rimio/cat-a-hack/README.md

# cat-a-hack

Prototyping board for PC/μC to ham radio transceiver isolation.

 This work is licensed under a [Creative Commons Attribution-ShareAlike 4.0 International License](http://creativecommons.org/licenses/by-sa/4.0/).
