rimio/cat-a-hack/revisions/0/schematic.pdf

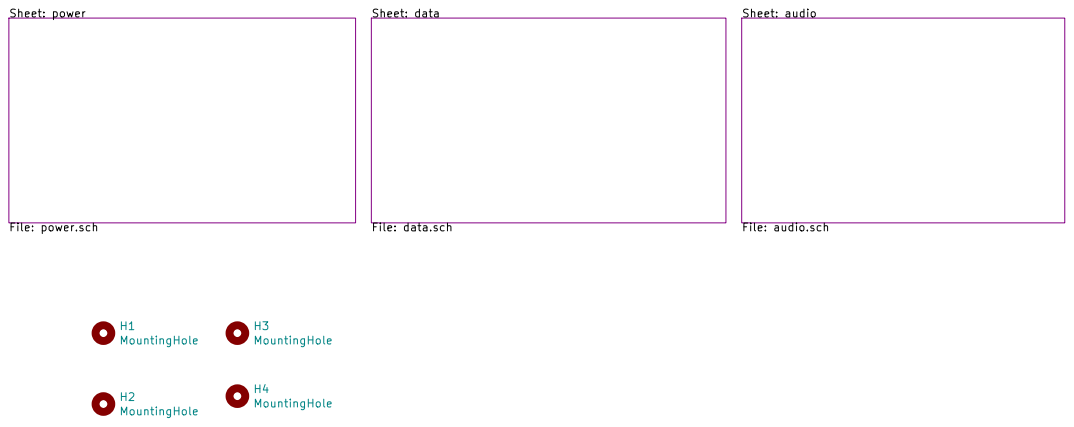
[picture p1: page 1]

File: catahack.sch Sheet: / Vasile Vilvoiu (YO7JBP) CAT and audio hackable isolation board

Id: 1/5 Title: cat-a-hack

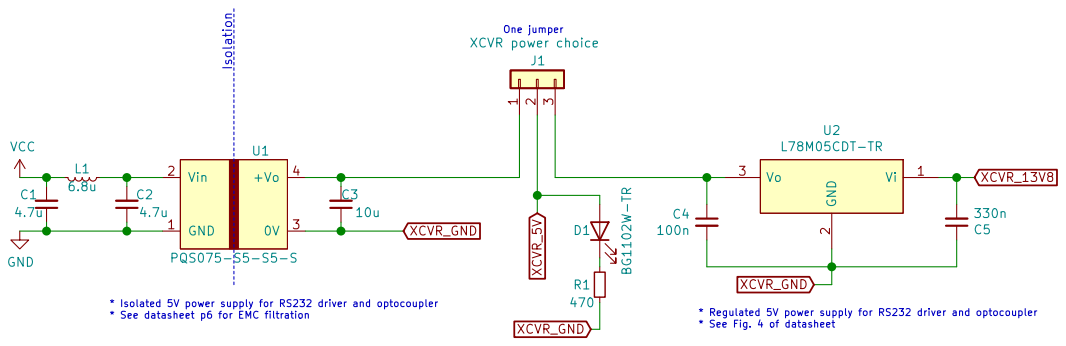
[picture p2: page 2]

Vasile Vilvoiu (YO7JBP) CAT and audio hackable isolation board Transceiver-side power circuit

Sheet: /power/
File: power.sch
Id: 2/5 Title: cat-a-hack

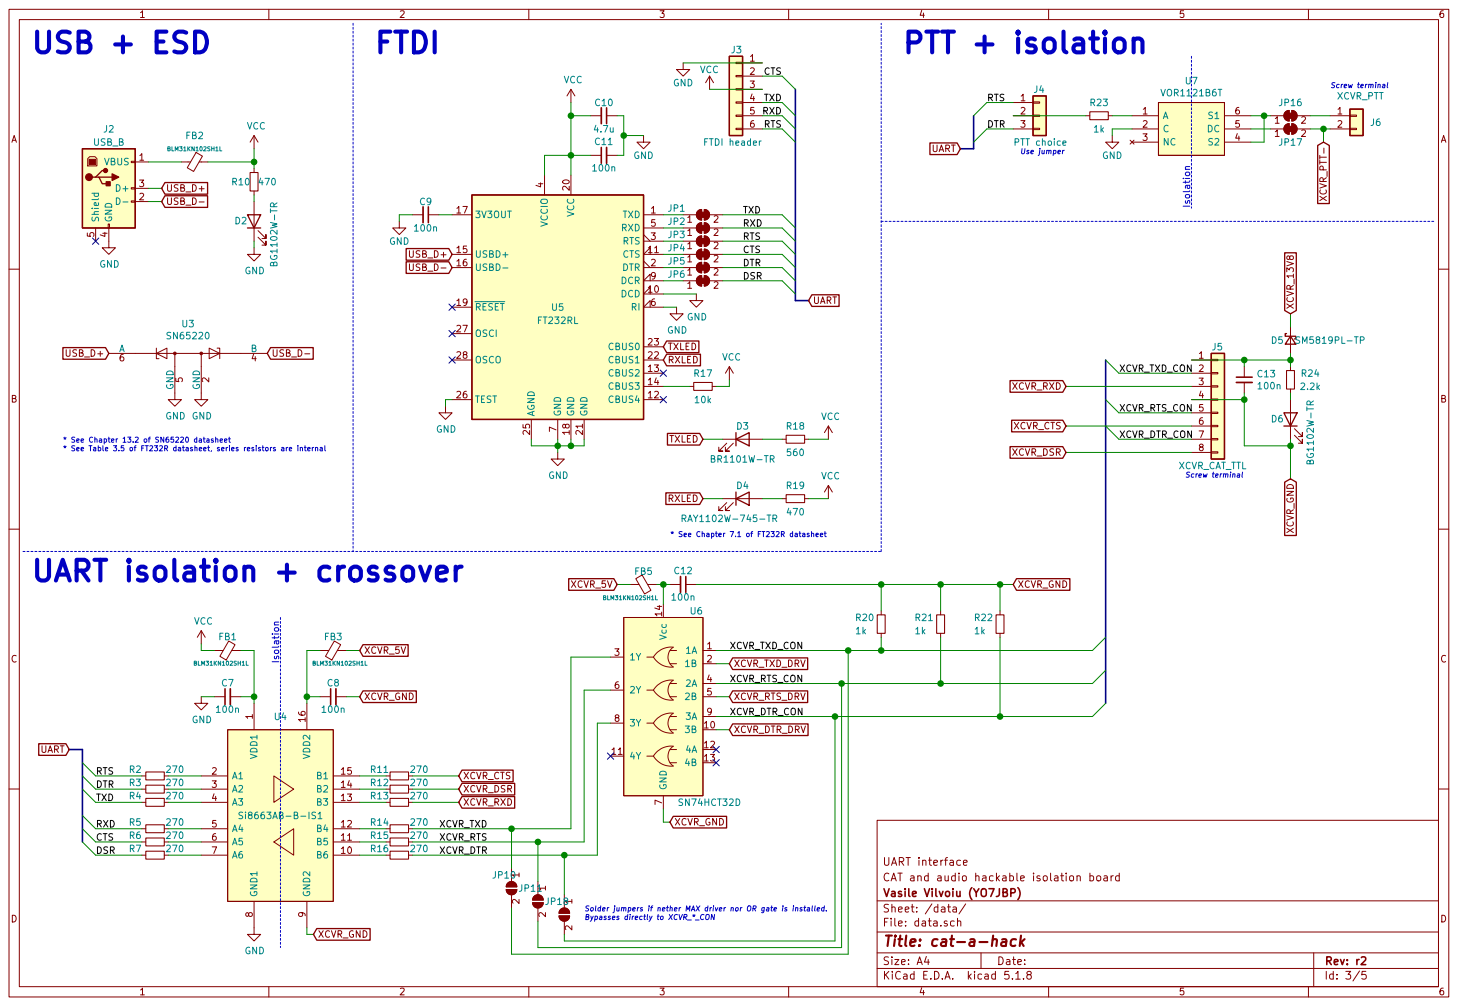
[picture p3: page 3]

Screw terminal UART isolation + crossover

Id: 3/5 Title: cat-a-hack

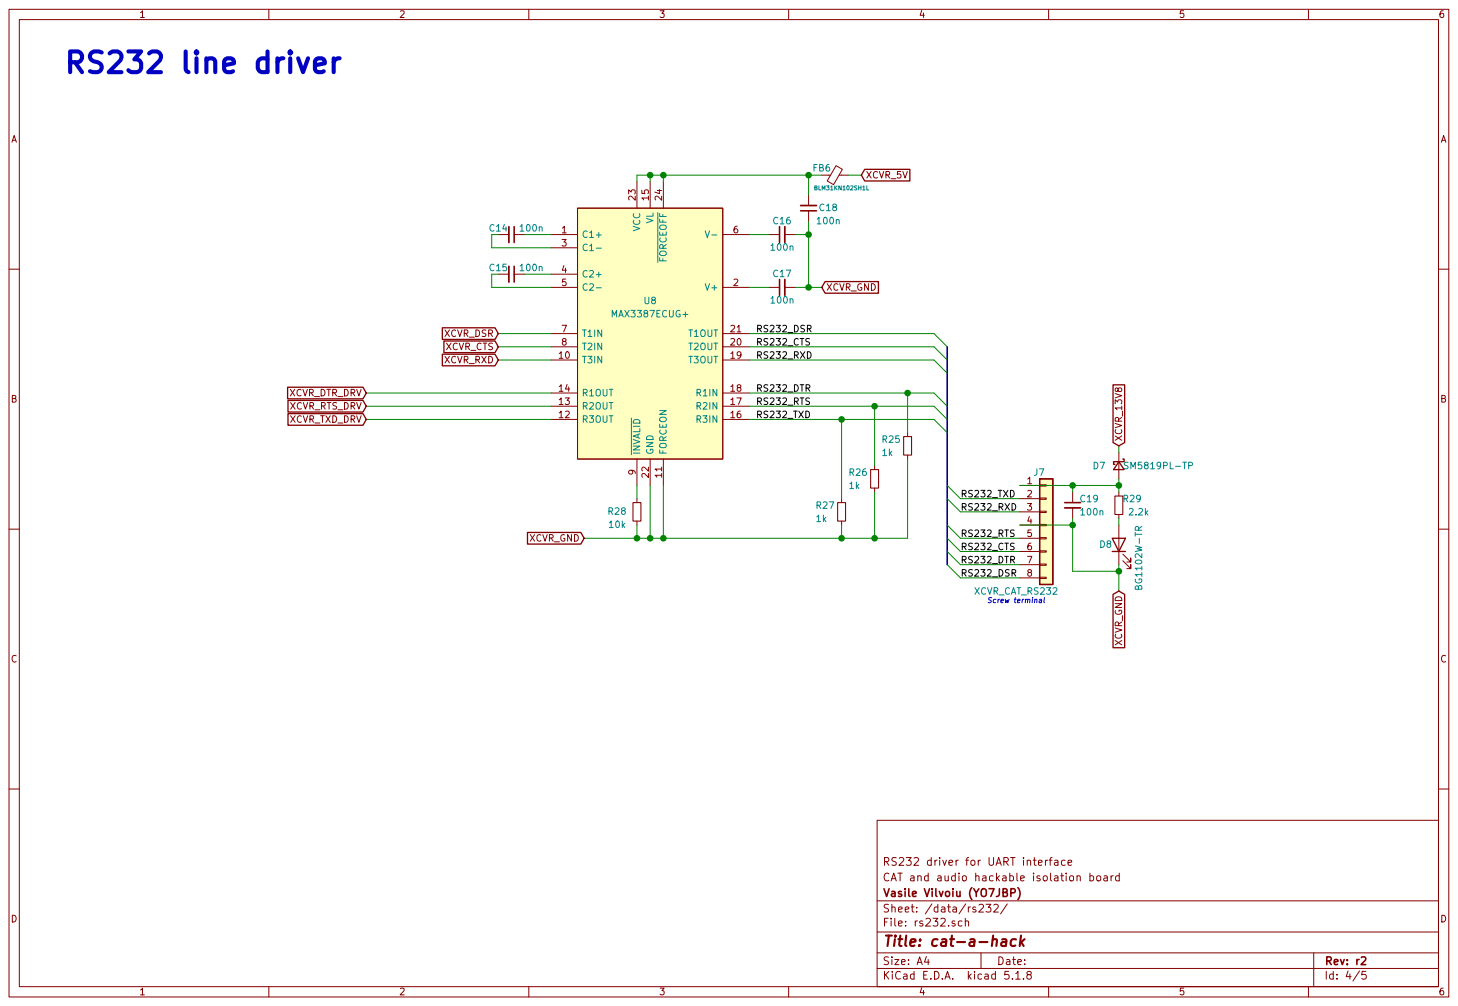
[picture p4: page 4]

File: rs232.sch Sheet: /data/rs232/ Vasile Vilvoiu (YO7JBP) CAT and audio hackable isolation board RS232 driver for UART interface

Id: 4/5 Title: cat-a-hack

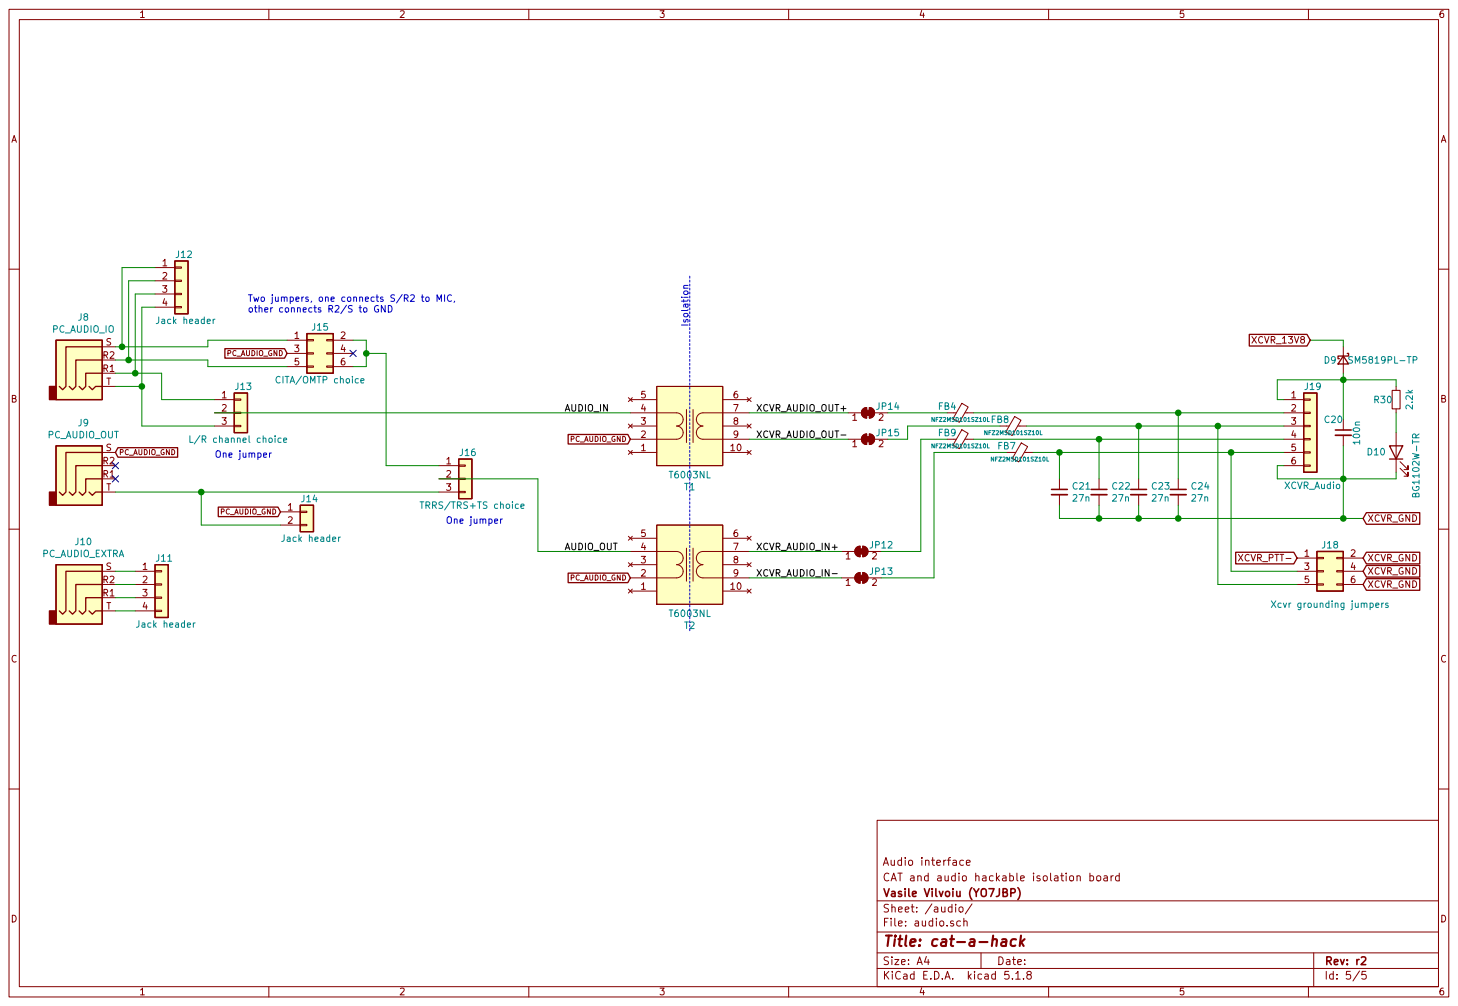
[picture p5: page 5]

Two jumpers, one connects S/R2 to MIC, other connects R2/S to GND

File: audio.sch Sheet: /audio/ Vasile Vilvoiu (YO7JBP) CAT and audio hackable isolation board Audio interface

Id: 5/5 Title: cat-a-hack
