rimio/cat-a-hack/kicad/catahack.kicad_pcb

## KiCad design kicad/catahack.kicad_pcb (2020-11-09)

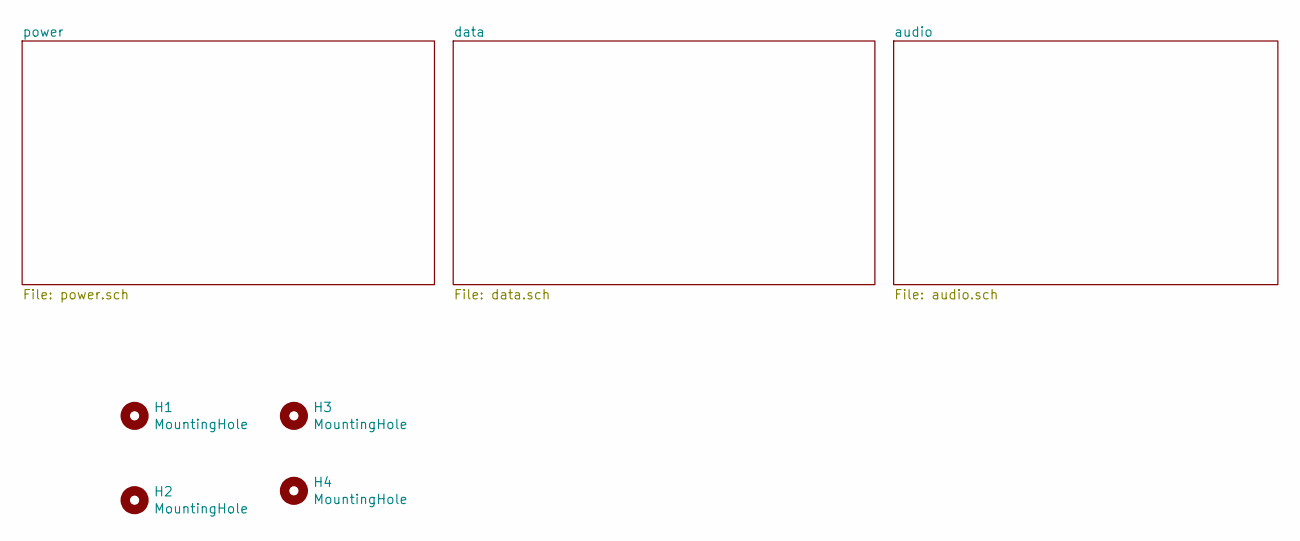
[picture p6: schematic catahack.sch, cat-a-hack]

Parts:
H1, H2, H3, H4: MountingHole; MountingHole_4.3mm_M4_ISO7380_Pad

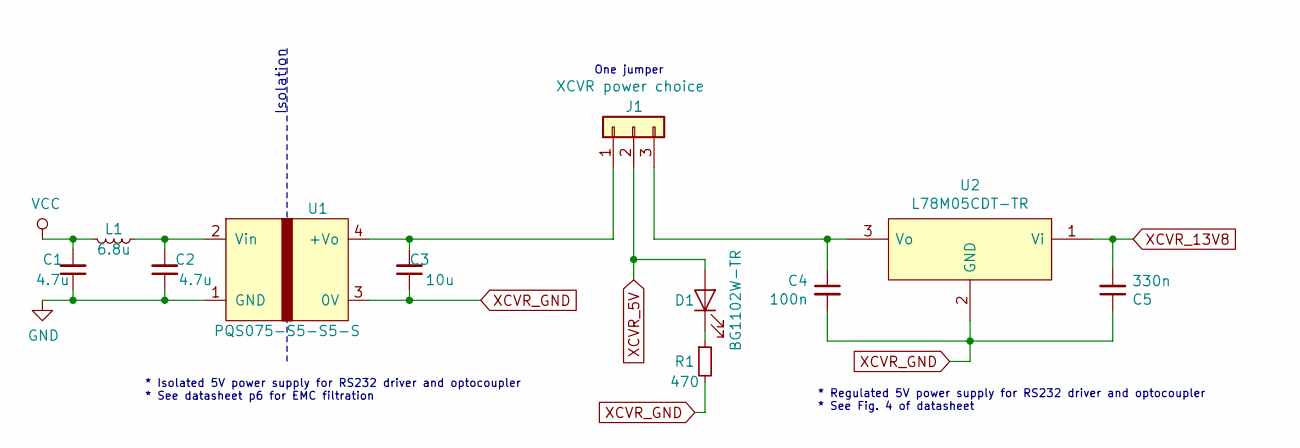
[picture p7: schematic power.sch, cat-a-hack]

Parts:
C1, C2: 4.7u; C_1206_3216Metric_Pad1.42x1.75mm_HandSolder
C3: 10u; C_1206_3216Metric_Pad1.42x1.75mm_HandSolder
C4: 100n; C_1206_3216Metric_Pad1.42x1.75mm_HandSolder
C5: 330n; C_1206_3216Metric_Pad1.42x1.75mm_HandSolder
D1: BG1102W-TR; LED_1206_3216Metric_Pad1.42x1.75mm_HandSolder
J1: XCVR power choice; PinHeader_1x03_P2.54mm_Vertical
L1: 6.8u; L_0805_2012Metric_Pad1.15x1.40mm_HandSolder
R1: 470; R_1206_3216Metric_Pad1.42x1.75mm_HandSolder
U1: PQS075-S5-S5-S; SIP-4_PQS075-S5-S5-S
U2: L78M05CDT-TR; TO-252-2; Mouser Part Number 511-L78M05CDT-TR

Connections:
GND: C1.1, C2.1, U1.1 (GND); also elsewhere on the board
unnamed: C2.2, L1.1, U1.2 (Vin)
unnamed: C3.2, J1.1, U1.4 (+Vo)
unnamed: C4.1, J1.3, U2.3 (Vo)
unnamed: D1.1 (K), R1.1
VCC: C1.2, L1.2; also elsewhere on the board
XCVR_5V: D1.2 (A), J1.2; also elsewhere on the board
XCVR_13V8: C5.2, U2.1 (Vi); also elsewhere on the board
XCVR_GND: C3.1, C4.2, C5.1, R1.2, U1.3 (0V), U2.2 (GND); also elsewhere on the board

Notes on the sheet:
* Isolated 5V power supply for RS232 driver and optocoupler * See datasheet p6 for EMC filtration
One jumper
Isolation
* Regulated 5V power supply for RS232 driver and optocoupler * See Fig. 4 of datasheet

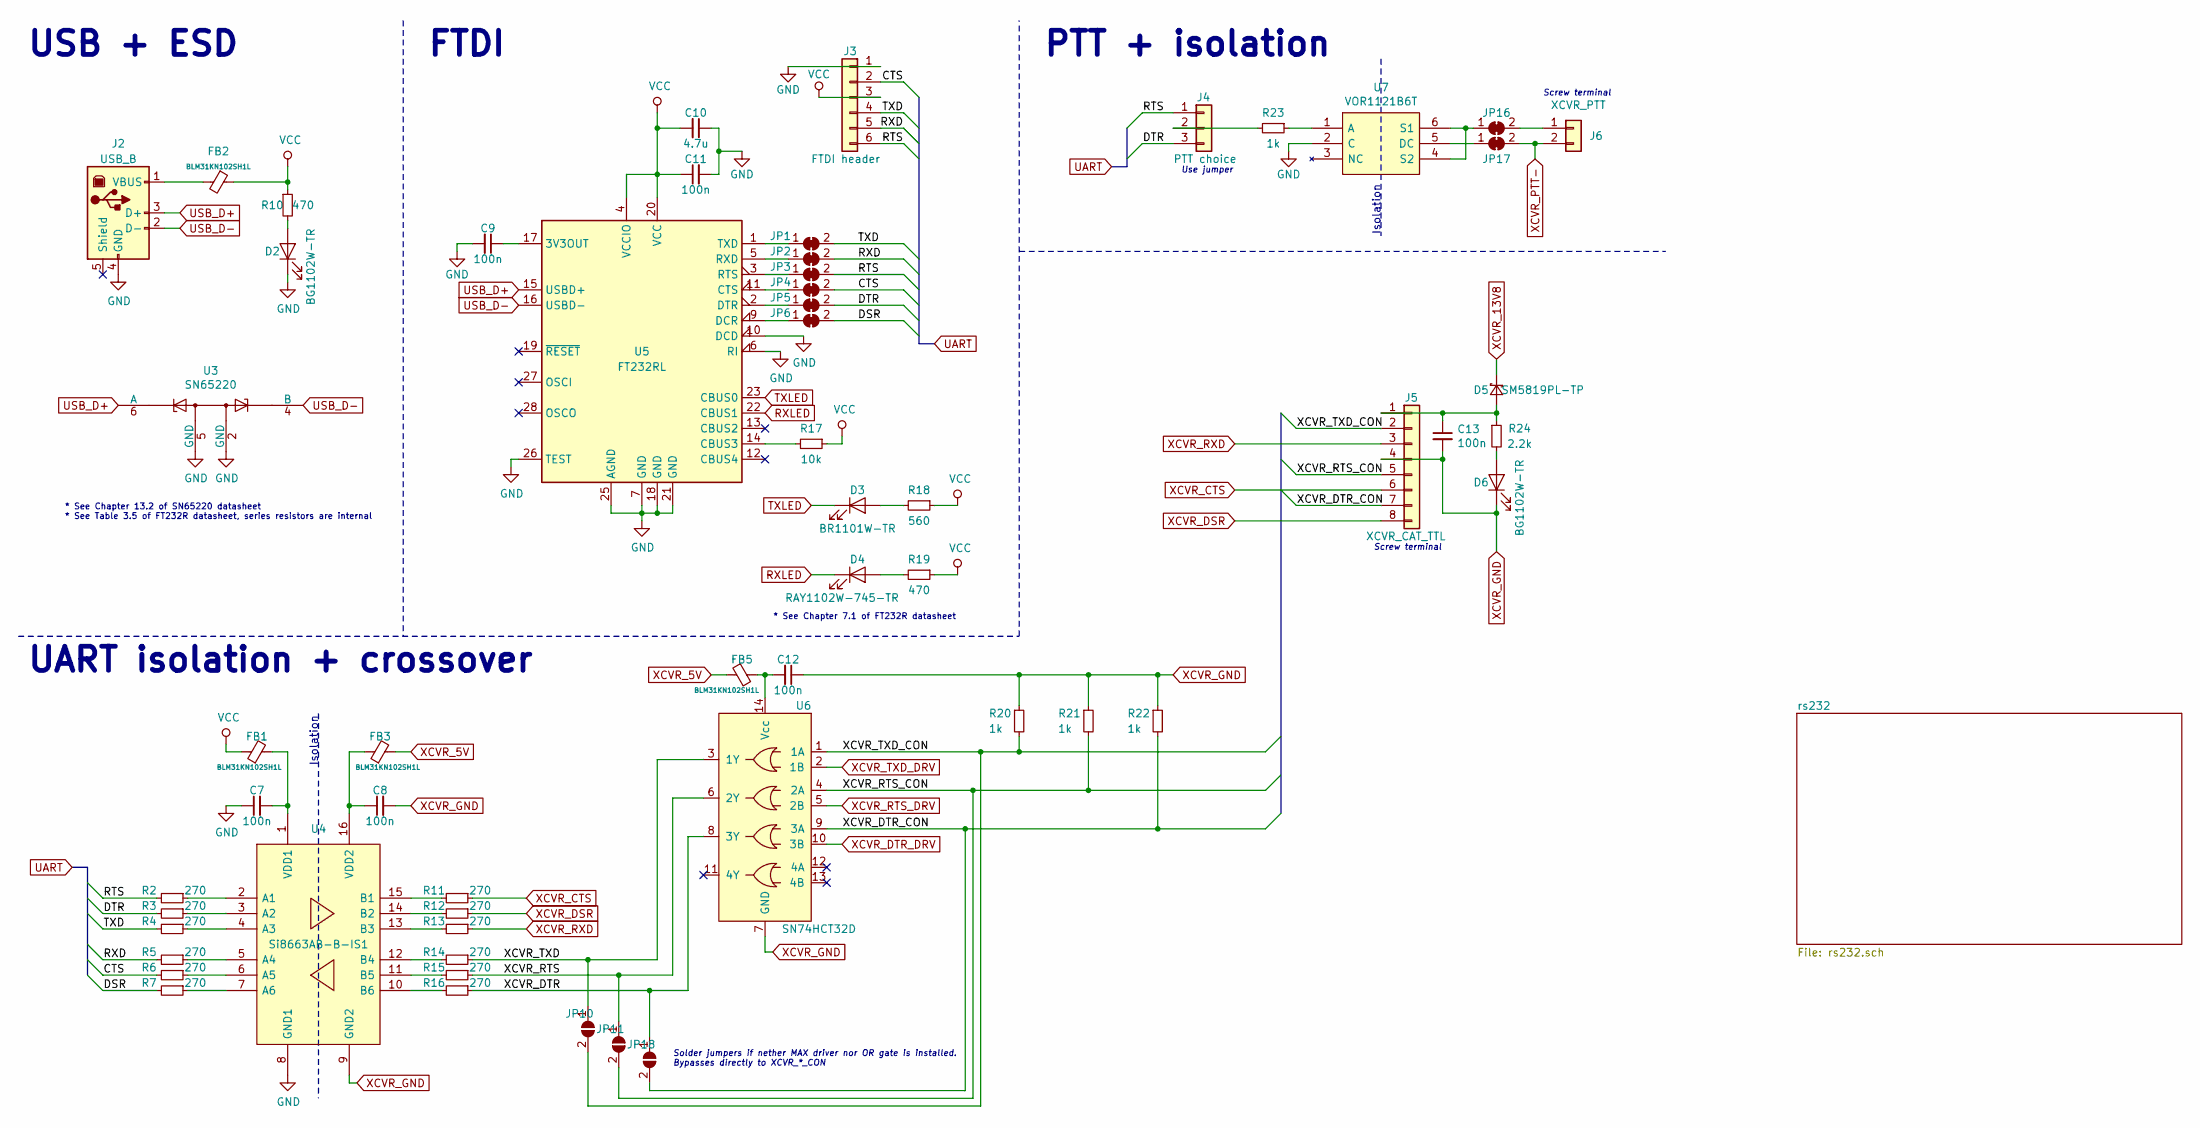
[picture p8: schematic data.sch, cat-a-hack]

Parts:
C7, C8, C9, C11, C12, C13: 100n; C_1206_3216Metric_Pad1.42x1.75mm_HandSolder
C10: 4.7u; C_1206_3216Metric_Pad1.42x1.75mm_HandSolder
D2, D6: BG1102W-TR; LED_1206_3216Metric_Pad1.42x1.75mm_HandSolder
D3: BR1101W-TR; LED_1206_3216Metric_Pad1.42x1.75mm_HandSolder
D4: RAY1102W-745-TR; LED_1206_3216Metric_Pad1.42x1.75mm_HandSolder
D5: SM5819PL-TP; D_SOD-123F
FB1, FB2, FB3, FB5: BLM31KN102SH1L; L_1206_3216Metric_Pad1.42x1.75mm_HandSolder
J2: USB_B; USB_B_OST_USB-B1HSxx_Horizontal
J3: FTDI header; PinHeader_1x06_P2.54mm_Vertical
J4: PTT choice; PinHeader_1x03_P2.54mm_Vertical
J5: XCVR_CAT_TTL; TB003-500-P08BE
J6: XCVR_PTT; TB003-500-P02BE
JP1, JP2, JP3, JP4, JP5, JP6, JP16, JP17: SolderJumper_2_Bridged; SolderJumper-2_P1.3mm_Bridged_RoundedPad1.0x1.5mm
JP10, JP11, JP18: SolderJumper_2_Open; SolderJumper-2_P1.3mm_Open_RoundedPad1.0x1.5mm
R2, R3, R4, R5, R6, R7, R11, R12, R13, R14, R15, R16: 270; R_1206_3216Metric_Pad1.42x1.75mm_HandSolder
R10, R19: 470; R_1206_3216Metric_Pad1.42x1.75mm_HandSolder
R17: 10k; R_1206_3216Metric_Pad1.42x1.75mm_HandSolder
R18: 560; R_1206_3216Metric_Pad1.42x1.75mm_HandSolder
R20, R21, R22, R23: 1k; R_1206_3216Metric_Pad1.42x1.75mm_HandSolder
R24: 2.2k; R_1206_3216Metric_Pad1.42x1.75mm_HandSolder
U3: SN65220; SOT-23-6_Handsoldering
U4: Si8663AB-B-IS1; SOIC-16_3.9x9.9mm_P1.27mm; Mouser Part Number 634-SI8663AB-B-IS1
U5: FT232RL; SSOP-28_5.3x10.2mm_P0.65mm
U6: SN74HCT32D; SOIC-14_P1.27mm_Handsolder
U7: VOR1121B6T; SMDIP-6_W9.53mm_Clearance8mm; Mouser Part Number 78-VOR1121B6T

Connections:
/data/CTS: J3.2, JP4.2 (B), R6.2
/data/DSR: JP6.2 (B), R7.2
/data/DTR: J4.3, JP5.2 (B), R3.2
/data/RTS: J3.6, J4.1, JP3.2 (B), R2.2
/data/RXD: J3.5, JP2.2 (B), R5.2
/data/TXD: J3.4, JP1.2 (B), R4.2
/data/XCVR_DTR: JP18.1 (A), R16.1, U6.8 (3Y)
/data/XCVR_DTR_CON: J5.7, JP18.2 (B), R22.2, U6.9 (3A)
/data/XCVR_RTS: JP11.1 (A), R15.1, U6.6 (2Y)
/data/XCVR_RTS_CON: J5.5, JP11.2 (B), R21.2, U6.4 (2A)
/data/XCVR_TXD: JP10.1 (A), R14.1, U6.3 (1Y)
/data/XCVR_TXD_CON: J5.2, JP10.2 (B), R20.2, U6.1 (1A)
GND: C7.1, C9.2, C10.1, C11.2, D2.1 (K), J2.4 (GND), J3.1, U3.2 (GND), U3.5 (GND), U4.8 (GND1), U5.6 (RI), U5.7 (GND), U5.10 (DCD), U5.18 (GND), U5.21 (GND), U5.25 (AGND), U5.26 (TEST), U7.2 (C); also elsewhere on the board
unnamed: C7.2, FB1.2, U4.1 (VDD1)
unnamed: C8.1, FB3.1, U4.16 (VDD2)
unnamed: C9.1, U5.17 (3V3OUT)
unnamed: C12.2, FB5.2, U6.14 (Vcc)
unnamed: C13.1, D5.2 (A), J5.1, R24.1
unnamed: D2.2 (A), R10.2
unnamed: D3.2 (A), R18.2
unnamed: D4.2 (A), R19.2
unnamed: D6.2 (A), R24.2
unnamed: FB2.2, J2.1 (VBUS)
unnamed: J4.2, R23.2
unnamed: J6.1, JP16.2 (B)
unnamed: JP1.1 (A), U5.1 (TXD)
unnamed: JP2.1 (A), U5.5 (RXD)
unnamed: JP3.1 (A), U5.3 (RTS)
unnamed: JP4.1 (A), U5.11 (CTS)
unnamed: JP5.1 (A), U5.2 (DTR)
unnamed: JP6.1 (A), U5.9 (DCR)
unnamed: JP16.1 (A), U7.4 (S2), U7.6 (S1)
unnamed: JP17.1 (A), U7.5 (DC)
unnamed: R2.1, U4.2 (A1)
unnamed: R3.1, U4.3 (A2)
unnamed: R4.1, U4.4 (A3)
unnamed: R5.1, U4.5 (A4)
unnamed: R6.1, U4.6 (A5)
unnamed: R7.1, U4.7 (A6)
unnamed: R11.2, U4.15 (B1)
unnamed: R12.2, U4.14 (B2)
unnamed: R13.2, U4.13 (B3)
unnamed: R14.2, U4.12 (B4)
unnamed: R15.2, U4.11 (B5)
unnamed: R16.2, U4.10 (B6)
unnamed: R17.2, U5.14 (CBUS3)
unnamed: R23.1, U7.1 (A)
RXLED: D4.1 (K), U5.22 (CBUS1)
TXLED: D3.1 (K), U5.23 (CBUS0)
USB_D+: J2.3 (D+), U3.6 (A), U5.15 (USBD+)
USB_D-: J2.2 (D-), U3.4 (B), U5.16 (USBD-)
VCC: C10.2, C11.1, FB1.1, FB2.1, J3.3, R10.1, R17.1, R18.1, R19.1, U5.4 (VCCIO), U5.20 (VCC); also elsewhere on the board
XCVR_5V: FB3.2, FB5.1; also elsewhere on the board
XCVR_13V8: D5.1 (K); also elsewhere on the board
XCVR_CTS: J5.6, R11.1; also elsewhere on the board
XCVR_DSR: J5.8, R12.1; also elsewhere on the board
XCVR_DTR_DRV: U6.10 (3B); also elsewhere on the board
XCVR_GND: C8.2, C12.1, C13.2, D6.1 (K), J5.4, R20.1, R21.1, R22.1, U4.9 (GND2), U6.7 (GND); also elsewhere on the board
XCVR_PTT-: J6.2, JP17.2 (B); also elsewhere on the board
XCVR_RTS_DRV: U6.5 (2B); also elsewhere on the board
XCVR_RXD: J5.3, R13.1; also elsewhere on the board
XCVR_TXD_DRV: U6.2 (1B); also elsewhere on the board

Notes on the sheet:
* See Chapter 13.2 of SN65220 datasheet * See Table 3.5 of FT232R datasheet, series resistors are internal
* See Chapter 7.1 of FT232R datasheet
USB + ESD
FTDI
PTT + isolation
Use jumper
Screw terminal
UART isolation + crossover
Isolation
Solder jumpers if nether MAX driver nor OR gate is installed. Bypasses directly to XCVR_*_CON

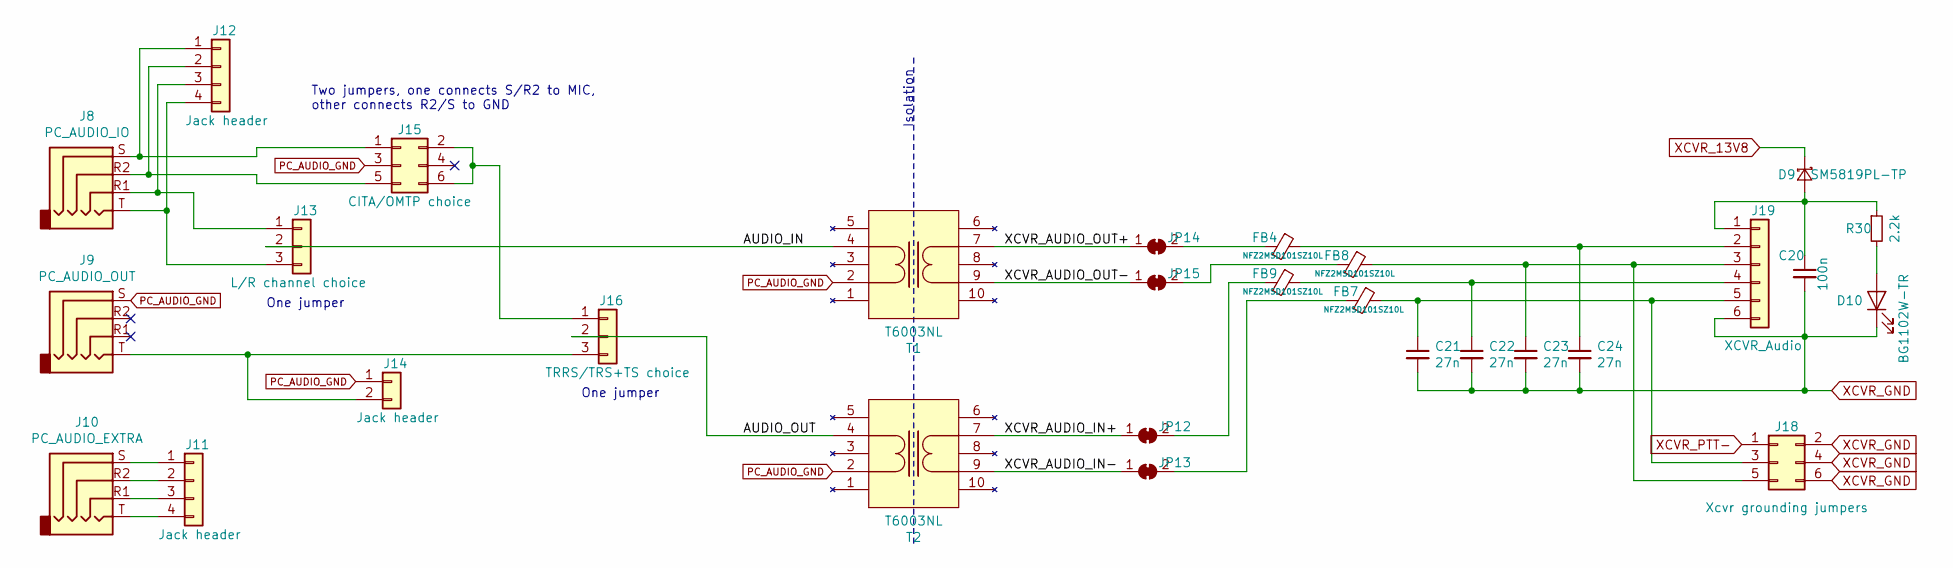
[picture p9: schematic audio.sch, cat-a-hack]

Parts:
C20: 100n; C_1206_3216Metric_Pad1.42x1.75mm_HandSolder
C21, C22, C23, C24: 27n; C_1206_3216Metric_Pad1.42x1.75mm_HandSolder
D9: SM5819PL-TP; D_SOD-123F
D10: BG1102W-TR; LED_1206_3216Metric_Pad1.42x1.75mm_HandSolder
FB4, FB7, FB8, FB9: NFZ2MSD101SZ10L; NFZ2MSD101SZ10L_0806_Handsolder
J8: PC_AUDIO_IO; SJ43514
J9: PC_AUDIO_OUT; SJ43514
J10: PC_AUDIO_EXTRA; SJ43514
J11, J12: Jack header; PinHeader_1x04_P2.54mm_Vertical
J13: L/R channel choice; PinHeader_1x03_P2.54mm_Vertical
J14: Jack header; PinHeader_1x02_P2.54mm_Vertical
J15: CITA/OMTP choice; PinHeader_2x03_P2.54mm_Vertical
J16: TRRS/TRS+TS choice; PinHeader_1x03_P2.54mm_Vertical
J18: Xcvr grounding jumpers; PinHeader_2x03_P2.54mm_Vertical
J19: XCVR_Audio; TB003-500-P06BE
JP12, JP13, JP14, JP15: SolderJumper_2_Bridged; SolderJumper-2_P1.3mm_Bridged_RoundedPad1.0x1.5mm
R30: 2.2k; R_1206_3216Metric_Pad1.42x1.75mm_HandSolder
T1, T2: T6003NL; T6003NL_HandSolder; Mouser Part Number 673-T6003NL

Connections:
/audio/AUDIO_IN: J13.2, T1.4
/audio/AUDIO_OUT: J16.2, T2.4
/audio/XCVR_AUDIO_IN+: JP12.1 (A), T2.7
/audio/XCVR_AUDIO_IN-: JP13.1 (A), T2.9
/audio/XCVR_AUDIO_OUT+: JP14.1 (A), T1.7
/audio/XCVR_AUDIO_OUT-: JP15.1 (A), T1.9
unnamed: C20.1, D9.2 (A), J19.1, R30.1
unnamed: C21.1, FB7.1, J18.3, J19.5
unnamed: C22.1, FB9.1, J19.4
unnamed: C23.1, FB8.1, J18.5, J19.3
unnamed: C24.1, FB4.1, J19.2
unnamed: D10.2 (A), R30.2
unnamed: FB4.2, JP14.2 (B)
unnamed: FB7.2, JP13.2 (B)
unnamed: FB8.2, JP15.2 (B)
unnamed: FB9.2, JP12.2 (B)
unnamed: J10.R1, J11.3
unnamed: J10.R2, J11.2
unnamed: J10.S, J11.1
unnamed: J10.T, J11.4
unnamed: J8.S, J12.1, J15.1
unnamed: J8.R2, J12.2, J15.5
unnamed: J8.R1, J12.3, J13.1
unnamed: J8.T, J12.4, J13.3
unnamed: J9.T, J14.2, J16.3
unnamed: J15.2, J15.6, J16.1
PC_AUDIO_GND: J9.S, J14.1, J15.3, T1.2, T2.2
XCVR_13V8: D9.1 (K); also elsewhere on the board
XCVR_GND: C20.2, C21.2, C22.2, C23.2, C24.2, D10.1 (K), J18.2, J18.4, J18.6, J19.6; also elsewhere on the board
XCVR_PTT-: J18.1; also elsewhere on the board

Notes on the sheet:
Isolation
Two jumpers, one connects S/R2 to MIC, other connects R2/S to GND
One jumper

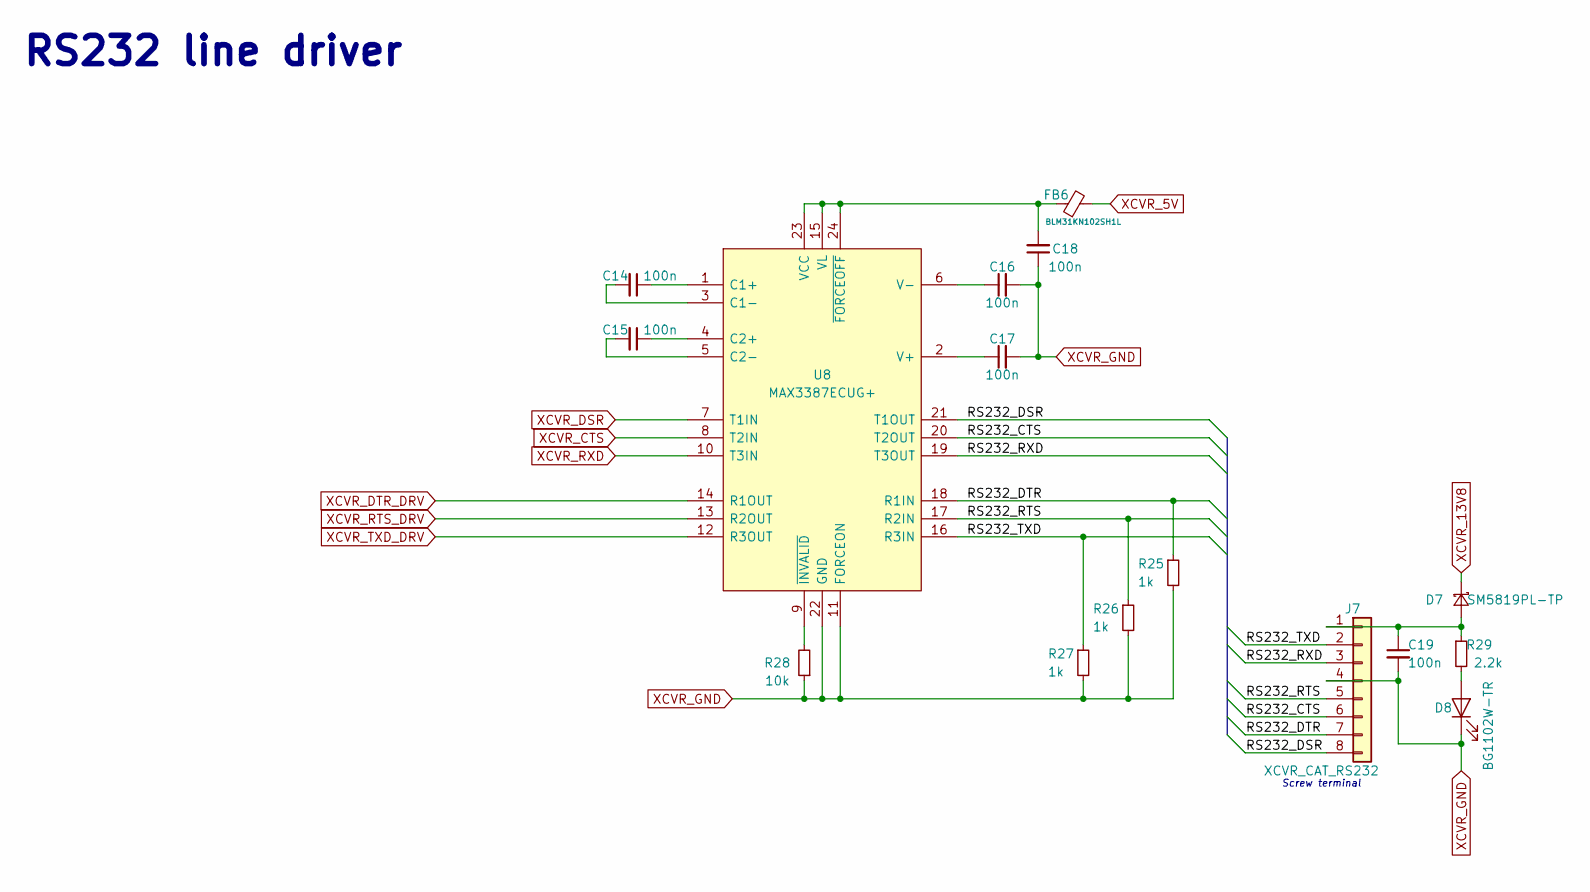
[picture p10: schematic rs232.sch, cat-a-hack]

Parts:
C14, C15, C16, C17, C18, C19: 100n; C_1206_3216Metric_Pad1.42x1.75mm_HandSolder
D7: SM5819PL-TP; D_SOD-123F
D8: BG1102W-TR; LED_1206_3216Metric_Pad1.42x1.75mm_HandSolder
FB6: BLM31KN102SH1L; L_1206_3216Metric_Pad1.42x1.75mm_HandSolder
J7: XCVR_CAT_RS232; TB003-500-P08BE
R25, R26, R27: 1k; R_1206_3216Metric_Pad1.42x1.75mm_HandSolder
R28: 10k; R_1206_3216Metric_Pad1.42x1.75mm_HandSolder
R29: 2.2k; R_1206_3216Metric_Pad1.42x1.75mm_HandSolder
U8: MAX3387ECUG+; TSSOP-24_4.4x7.8mm_P0.65mm; Mouser Part Number 700-MAX3387ECUG

Connections:
/data/rs232/RS232_CTS: J7.6, U8.20 (T2OUT)
/data/rs232/RS232_DSR: J7.8, U8.21 (T1OUT)
/data/rs232/RS232_DTR: J7.7, R25.1, U8.18 (R1IN)
/data/rs232/RS232_RTS: J7.5, R26.1, U8.17 (R2IN)
/data/rs232/RS232_RXD: J7.3, U8.19 (T3OUT)
/data/rs232/RS232_TXD: J7.2, R27.1, U8.16 (R3IN)
unnamed: C14.1, U8.1 (C1+)
unnamed: C14.2, U8.3 (C1-)
unnamed: C15.1, U8.4 (C2+)
unnamed: C15.2, U8.5 (C2-)
unnamed: C16.1, U8.6 (V-)
unnamed: C17.1, U8.2 (V+)
unnamed: C18.2, FB6.1, U8.15 (VL), U8.23 (VCC), U8.24 (~FORCEOFF)
unnamed: C19.1, D7.2 (A), J7.1, R29.1
unnamed: D8.2 (A), R29.2
unnamed: R28.2, U8.9 (~INVALID)
XCVR_5V: FB6.2; also elsewhere on the board
XCVR_13V8: D7.1 (K); also elsewhere on the board
XCVR_CTS: U8.8 (T2IN); also elsewhere on the board
XCVR_DSR: U8.7 (T1IN); also elsewhere on the board
XCVR_DTR_DRV: U8.14 (R1OUT); also elsewhere on the board
XCVR_GND: C16.2, C17.2, C18.1, C19.2, D8.1 (K), J7.4, R25.2, R26.2, R27.2, R28.1, U8.11 (FORCEON), U8.22 (GND); also elsewhere on the board
XCVR_RTS_DRV: U8.13 (R2OUT); also elsewhere on the board
XCVR_RXD: U8.10 (T3IN); also elsewhere on the board
XCVR_TXD_DRV: U8.12 (R3OUT); also elsewhere on the board

Notes on the sheet:
RS232 line driver
Screw terminal

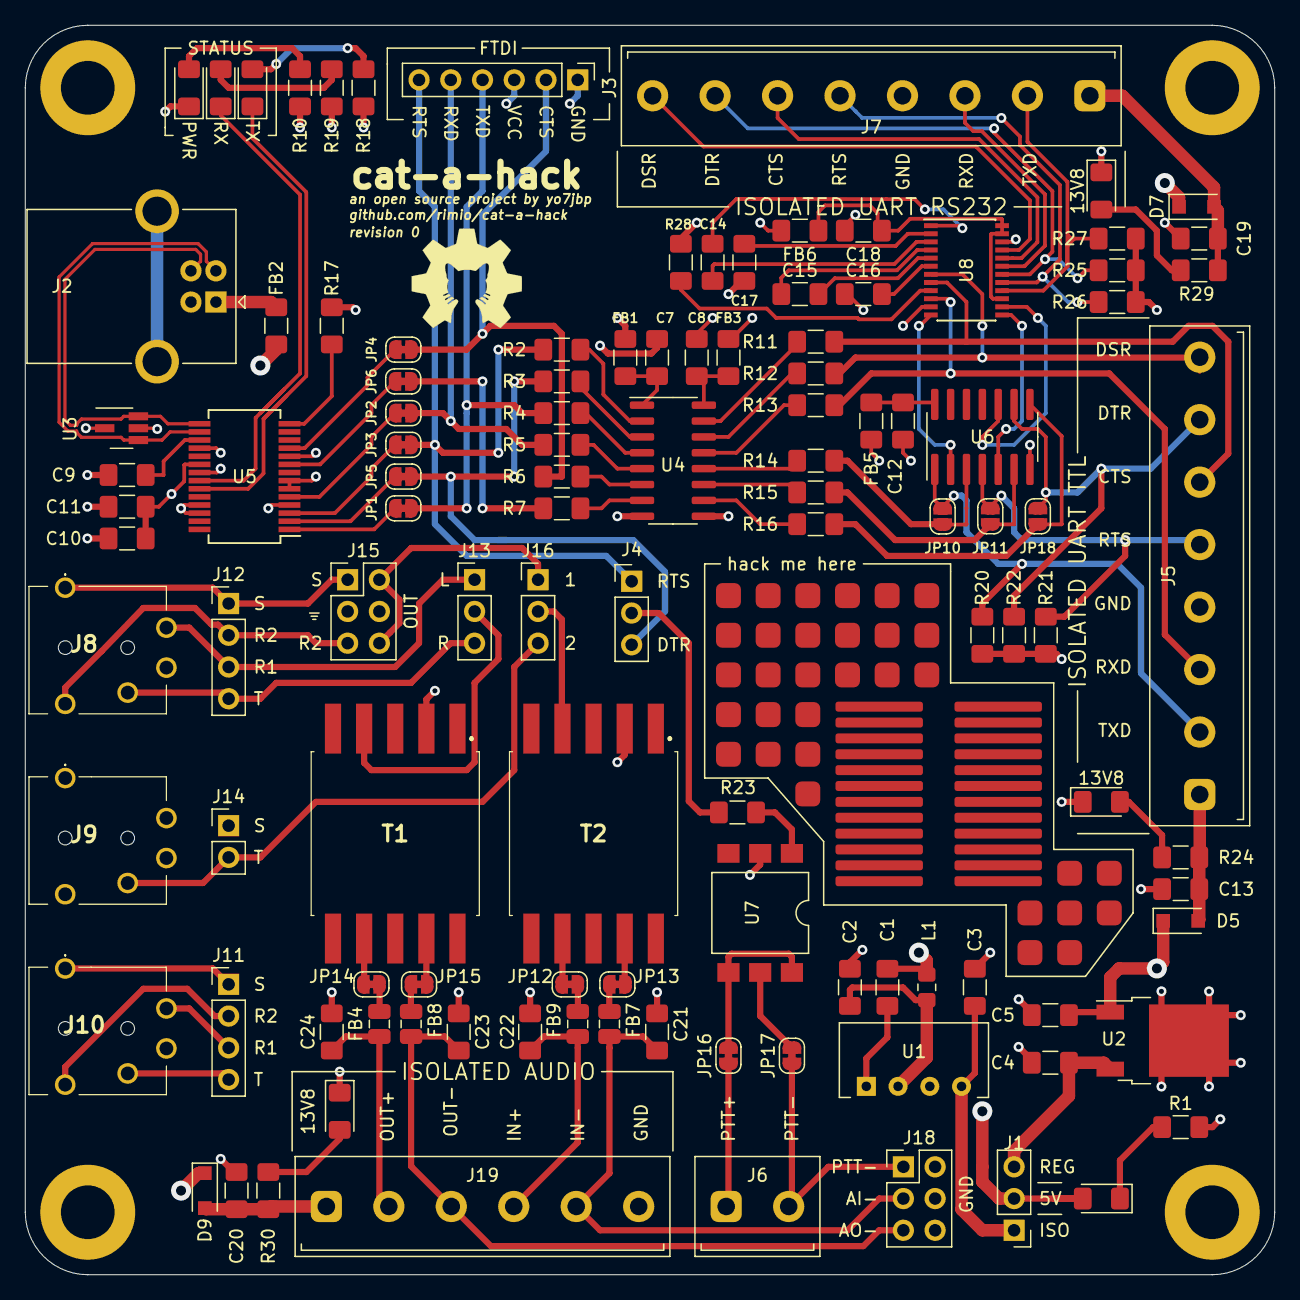
[picture p11: board catahack.kicad_pcb from above]

Board: 4 copper layers, 100.0 x 100.0 mm, 118 parts (0 on the bottom side), 109 nets.
