rimio/cat-a-hack/(threads)

Thread 1 (2020-11-23):

Misuse of RS232 inverted output line driver

rimio, 2020-11-23:
The MAX3387 line driver has inverting outputs (pins 12-14), and as a result always drives the TTL TX lines high when the RS232 terminals are not in use.

Find another driver or invert outputs.
