rimio/cat-a-hack/(commit log)

2020-10-31 Add kicad dir
2020-10-31 Initial commit.
    [audio.sch, catahack.kicad_pcb, catahack.sch, data.sch, power.sch]
2020-10-31 Change DC-DC convertor; other small changes
    * Change RFM-0505S (unregulated) to PQS075-S5-S5-S (regulated)
    * Naming conventions
    * Alignment
    [data.sch, power.sch]
2020-10-31 Fixed reversed I/O on MAX line driver
    [data.sch]
2020-11-01 Filtering, jumpers, LEDs, misc
    * Modified high level diagram to express the shared UART bus
    * Renamed XCVR_VCC to XCVR_13V8
    * Add solder jumpers on audio, PTT and UART lines for easy prototyping/bypassing
    * Added bypass caps on XCVR side data and audio connectors
    * Add series ferite beads on data ICs Vcc
    * Added schottky diodes to all XCVR_13V8
    * Changed series resistors of RXLED/TXLED/VccLED for 6mA current
    * Added power LEDs on XCVR_13V8 connector terminals
    * Added power LED for XCVR_5V rail
    [audio.sch, data.sch, power.sch]
2020-11-01 MAX driver protection
    * Adjust label position for readability
    * Protected R1OUT-R3OUT of MAX driver with OR gate
    [audio.sch, catahack.sch, data.sch, power.sch, rs232.sch]
2020-11-01 Connector and pull down resistors
    * Changed back to USB-B connector.
    * Changed value of pull down resistors to 1k.
    [data.sch, rs232.sch]
2020-11-02 Initial footprint placement + changes
    * Added initial placement
    * Remove pull-down resistors from USB lines.
    * Remove ferrite bead from FTDI chip as it was very close to Vcc FB
    * Fixed MAX TX pins
    * Assigned footprints.
    * Removed redundant solder jumpers.
    * Small changes for layout coherence.
    [audio.sch, catahack.kicad_pcb, catahack.sch, data.sch, power.sch, rs232.sch]
2020-11-03 New layout, routing, misc...
    * Redo layout
    * Fixed MAX pulldown resistors on data lines.
    * Added jumpers in case MAX not installed.
    * Remove audio header
    * Remove some redundant solder jumpers
    [audio.sch, catahack.kicad_pcb, data.sch, rs232.sch]
2020-11-03 Logo and small corrections
    * Added logo
    * Connected a few unconnected pads
    * Fixed GND pour intersection
    [catahack.kicad_pcb]
2020-11-04 Audio filtering, hackable area, misc
    * Added bypass caps and ferrites to audio lines
    * Small rerouting
    * Hackable area
    * Added rev no
    [audio.sch, catahack.kicad_pcb, data.sch]
2020-11-04 Ferrite beads, hacking pads, audio fix
    * Chose ferrite beads for IC Vcc (BLM31KN102SH1L)
    * Change hacking pad thickness to 0.8mm
    * Fixed potential oscillator when grounding audio- lines
    [audio.sch, catahack.kicad_pcb, data.sch, rs232.sch]
2020-11-05 Removed extra bypass cap from USB VBUS pin due to closeness to FTDI bypass cap; rerouted some traces
    [catahack.kicad_pcb, data.sch]
2020-11-05 Small fixes
    * Moved via that was unreasonably close to another one
    * Changed 13V8 diodes to SM5819PL-TP
    [audio.sch, catahack.kicad_pcb, data.sch, rs232.sch]
2020-11-05 Bugfixes
    * Fixed USB D+/D- switch
    * Added clearance at top right mounting hole
    [catahack.kicad_pcb, data.sch]
2020-11-05 Changed L1 to 0805 due to stock issues
    [catahack.kicad_pcb, power.sch]
2020-11-07 Changed resistor reference location and size; changed gitignore to include gerber dir
    [catahack.kicad_pcb]
2020-11-09 Enable B soldermask layer; add BOM
    [catahack.kicad_pcb]
2020-11-23 Added rev 0 schematic and gerber files
    [catahack-B_Cu.gbr, catahack-B_Mask.gbr, catahack-B_SilkS.gbr, catahack-Edge_Cuts.gbr, catahack-F_Cu.gbr, catahack-F_Mask.gbr, catahack-F_SilkS.gbr, catahack-In1_Cu.gbr]
2021-01-05 Match revision to directory name
    [catahack-B_Cu.gbr, catahack-B_Mask.gbr, catahack-B_SilkS.gbr, catahack-Edge_Cuts.gbr, catahack-F_Cu.gbr, catahack-F_Mask.gbr, catahack-F_SilkS.gbr, catahack-In1_Cu.gbr]
2021-01-05 Using board revision
    [catahack-B_Cu.gbr, catahack-B_Mask.gbr, catahack-B_SilkS.gbr, catahack-Edge_Cuts.gbr, catahack-F_Cu.gbr, catahack-F_Mask.gbr, catahack-F_SilkS.gbr, catahack-In1_Cu.gbr]
